mladjom/LA1074-CC-CV/releases/LA1074_v1.0.pdf

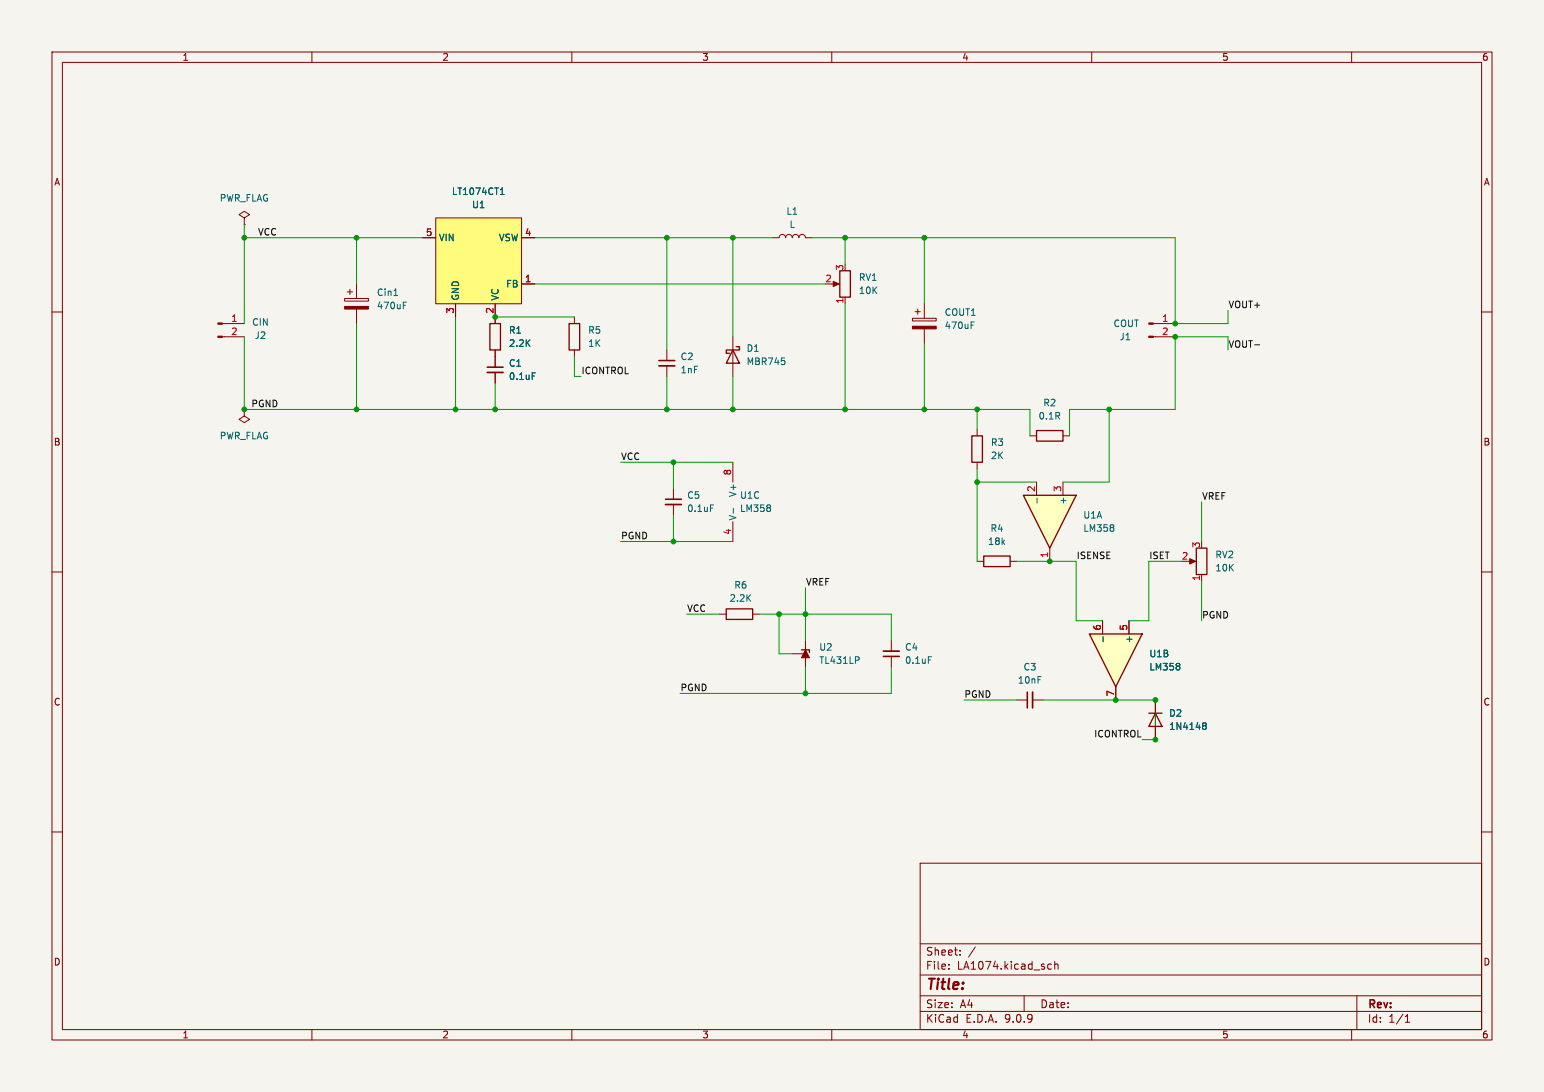
[picture p1: page 1]

Id: 1/1 Title: File: LA1074.kicad_sch Sheet: /
