mladjom/LA1074-CC-CV/LA1074.kicad_pcb

## KiCad design LA1074.kicad_pcb (2026-10-03)

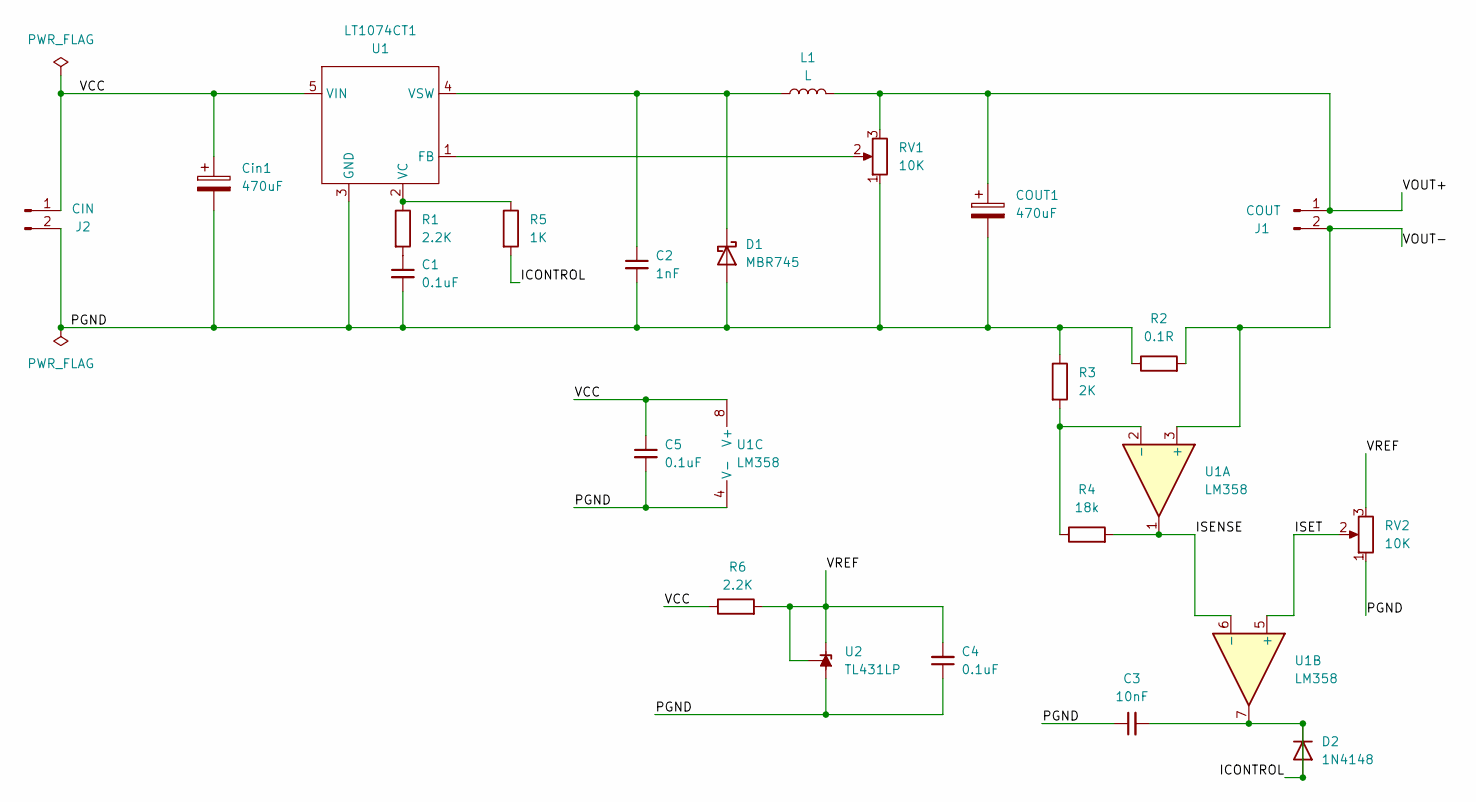
[picture p2: schematic LA1074.kicad_sch]

Parts:
C1, C4, C5: 0.1uF; C_Disc_D5.0mm_W2.5mm_P5.00mm
C2: 1nF; C_Disc_D5.0mm_W2.5mm_P5.00mm
C3: 10nF; C_Disc_D5.0mm_W2.5mm_P5.00mm
COUT1: 470uF; CP_Radial_D8.0mm_P3.50mm
Cin1: 470uF; CP_Radial_D8.0mm_P3.50mm
D1: MBR745; D_DO-41_SOD81_P10.16mm_Horizontal
D2: 1N4148; D_DO-35_SOD27_P7.62mm_Horizontal
J1: COUT; PinHeader_1x02_P2.54mm_Horizontal
J2: CIN; PinHeader_1x02_P2.54mm_Horizontal
L1: L; L_Axial_L20.0mm_D8.0mm_P25.40mm_Horizontal
LT1074CT1: U1; TO-220-5_Vertical
R1, R6: 2.2K; R_Axial_DIN0207_L6.3mm_D2.5mm_P7.62mm_Horizontal
R2: 0.1R; R_Axial_DIN0411_L9.9mm_D3.6mm_P12.70mm_Horizontal
R3: 2K; R_Axial_DIN0207_L6.3mm_D2.5mm_P7.62mm_Horizontal
R4: 18k; R_Axial_DIN0207_L6.3mm_D2.5mm_P7.62mm_Horizontal
R5: 1K; R_Axial_DIN0207_L6.3mm_D2.5mm_P7.62mm_Horizontal
RV1, RV2: 10K; PinSocket_1x03_P2.54mm_Vertical
U1: LM358; DIP-8_W7.62mm
U2: TL431LP; TO-92

Connections:
/ICONTROL: C3.2, D2.1 (K), D2.2 (A), R5.2, U1.7
/ISENSE: R4.2, U1.1, U1.6 (-)
/ISET: RV2.2, U1.5 (+)
/PGND: C1.2, C2.2, C3.1, C4.1, C5.2, COUT1.2, Cin1.2, D1.2 (A), J2.2, LT1074CT1.3 (GND), R2.1, R3.1, RV1.1, RV2.1, U1.4 (V-), U2.2 (A)
/VCC: C5.1, Cin1.1, J2.1, LT1074CT1.5 (VIN), R6.1, U1.8 (V+)
/VOUT+: COUT1.1, J1.1, L1.2, RV1.3
/VOUT-: J1.2, R2.2, U1.3 (+)
/VREF: C4.2, R6.2, RV2.3, U2.1 (REF), U2.3 (K)
unnamed: C1.1, R1.2
unnamed: C2.1, D1.1 (K), L1.1, LT1074CT1.4 (VSW)
unnamed: LT1074CT1.1 (FB), RV1.2
unnamed: LT1074CT1.2 (VC), R1.1, R5.1
unnamed: R3.2, R4.1, U1.2 (-)

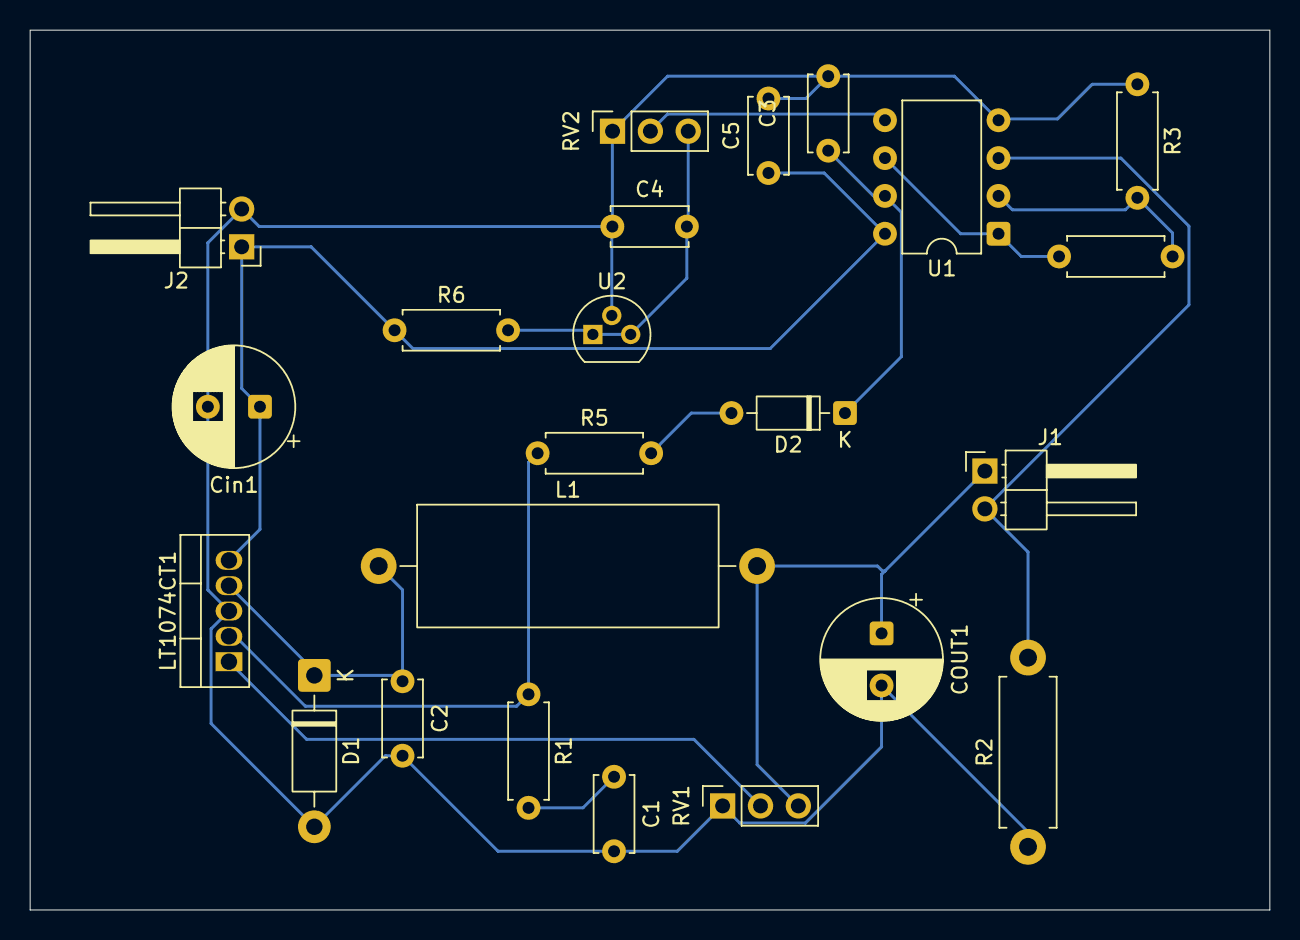
[picture p3: board LA1074.kicad_pcb from above]

Board: 2 copper layers, 83.2 x 59.1 mm, 23 parts (0 on the bottom side), 13 nets.
